foxyblocks/firewalker/docs/power-budget.md

# Power budget

Why current is the ceiling on this rig, and what the brightness settings mean for each
supported power setup.

## The numbers

BTF's [specification for the 160-pixel FCOB strip](https://www.btf-lighting.com/products/fcob-rgb-addressable-led-strip-dc5v-160pixels)
lists up to **8 W per meter at 5 V**. With 160 pixels per meter, that's about 10 mA per
pixel at full white. These are rated figures, not measurements of this strip, and its idle
current hasn't been measured yet either. Every connected pixel controller draws idle power
even when showing black.

A boot needs about **69 cm of strip, which is about 110 pixels**. That's a measured length
with the exact cut point still open, so these numbers will shift slightly. At full white:

| Strip | Pixels | Power | Current |
|---|---|---|---|
| One boot, cut to about 69 cm | ~110 | ~5.5 W | ~1.1 A |
| Both boots, if they ever share one supply | ~220 | ~11 W | ~2.2 A |
| Uncut bench strip | 160 | ~8 W | ~1.6 A |

The firmware applies brightness to every channel, so requested current scales roughly with
`brightness / 255`, and with how many channels and pixels are lit. For one boot:

| Brightness | ~110 pixels, white | ~110 pixels, 2-channel color | ~110 pixels, 1-channel color | Uncut strip, white |
|---|---|---|---|---|
| `16` | ~69 mA | ~46 mA | ~23 mA | ~100 mA |
| `32` | ~138 mA | ~92 mA | ~46 mA | ~200 mA |
| `64` | ~276 mA | ~184 mA | ~92 mA | ~400 mA |
| `96` (soft cap and default, 100% in the app) | ~414 mA | ~276 mA | ~138 mA | ~602 mA |
| `128` | ~552 mA | ~368 mA | ~184 mA | ~803 mA |
| `255` | ~1.1 A | ~733 mA | ~367 mA | ~1.6 A |

## What the patterns draw

- **rainbow-pool** cycles one hue through the spectrum, so a full strip passes through
  2-channel colors (yellow, cyan, magenta). It rests at 80% per-pixel brightness when
  level, and a level stomp flashes the whole strip **white**, which is its worst case.
- **fire-stomp** lights moving bands with white heads cooling through yellow and orange
  to red. Its white heads can use all three channels; overlapping bands can fill the strip.

## Power profiles

**USB, with the soft cap on.** The strip runs from the XIAO's 5V pad, which carries USB
power. Seeed's MG24 Sense schematic (v1.1) disagrees with itself about the path. Its wiring
sheet feeds the pad through one diode, D1 (PSBD2FD40V1H, printed "40V 1A 550mV@1A"), which
the board's own 3.3 V regulator shares. Its block diagram, and the pin map on Seeed's wiki,
put the pad straight on VBUS. Neither shows a fuse. If D1 is in the path, it limits the pad
to 1 A, and the strip gets up to about half a volt less than the USB supply. The USB source
sets its own limit too: 500 mA from a USB 2.0 computer port, and more from a USB-C charger
or power bank. Neither Seeed's MG24 wiki nor the schematic gives a current rating for the pad.

`LED_BRIGHTNESS_SOFT_CAP` in [`config.h`](../include/config.h) holds brightness at 96 while a
boot's soft cap is on, which it is on a new boot. On the
longest boot strip, 107 pixels, that keeps a full-white frame near 400 mA by its rating,
which fits even a USB 2.0 port, with or without D1. The uncut bench strip would reach
about 600 mA at that cap, so run it at a lower brightness. Not yet checked: whether D1 is
really in the path, its heat derating, the pad's trace width, and a meter reading on a real
board.

**External 5 V, with the soft cap off.** Feed the strip directly from a 5 V supply, with
grounds tied together (see [`wiring.md`](wiring.md)). Rate it for at least 1.5 A per cut strip,
which leaves headroom over the ~1.1 A full-white draw, or 2 A for the uncut strip. Then turn the
cap off from the remote: the Cap toggle beside the brightness percent, or `cap off`
([`remote-protocol.md`](remote-protocol.md)). With it off, brightness goes up to 255, about
1.07 A at full white on 107 pixels. That's over a USB 2.0 port's 500 mA and possibly over D1's
1 A, so don't run uncapped from USB. Each boot saves whether its cap is on, so turn it back on
before going back to USB.

Changing the soft cap's level takes a build flag, `FIREWALKER_LED_BRIGHTNESS_SOFT_CAP`. A capped
boot whose saved brightness is over a lower cap loads at the cap and keeps its other settings.

`./cli --brightness` accepts up to 255 regardless of the cap, because it's a deliberate
bench override. Keep it within the profile you're actually powering.

The final battery design is outside this budget, and is tracked in
[`open-questions.md`](open-questions.md).

## Levers to stay safe

- Lower the brightness, which scales everything.
- Reduce the recipe trail's `length` or `maxFronts` in `patterns/`.
- Estimate before raising anything: pixels lit × per-pixel current, against the real
  budget of the power source.
