foxyblocks/firewalker/docs/adr/0001-use-platformio-arduino-framework.md

# ADR-0001: Use PlatformIO with the Arduino framework

- **Status:** Accepted
- **Date:** 2026-05-31
- **Note:** The decision stands, but the boards and environments below are history. The
  current target is the XIAO MG24 Sense; see ADR-0004 and `platformio.ini`.

## Context

This is a wearable NeoPixel shoe project. We want a modern, reproducible,
VS Code-based workflow with real dependency management and CLI builds — not a
one-off Arduino IDE sketch. The first test board is an Arduino Uno R3
(ATmega328P / AVR). The project later moved to an Adafruit Feather RP2040 as
the active controller.

## Decision

Use **PlatformIO** as the build/dependency/upload tool, targeting the
**Arduino framework**. Configuration lives in `platformio.ini`, currently with
Adafruit Feather RP2040 environments for each runtime mode (`final_app`,
`fsr_debug`, `imu_debug`). Shared libraries (e.g. Adafruit NeoPixel) are declared
in the base `[env]`; mode-specific ones (e.g. Adafruit MPU6050 for `imu_debug`)
are added per-env so they aren't linked into builds that don't need them. All are
version-pinned via `lib_deps`.

## Consequences

- Reproducible CLI builds (`pio run`), uploads (`pio run -t upload`), and serial
  monitoring (`pio device monitor`) — scriptable and CI-friendly.
- Declarative, pinned dependencies instead of the IDE's global library mess.
- Switching/adding boards is a new `[env:*]` block; the Arduino framework keeps
  most application code portable across supported targets.
- Slightly more upfront config than the Arduino IDE, and contributors must
  install PlatformIO. Acceptable for a deliberate, long-lived project.

## Alternatives considered

- **Arduino IDE sketch** — lowest friction, but no real dependency pinning, no
  CLI/CI story, awkward multi-board support. Rejected.
- **Bare avr-gcc / Makefile** — maximal control, but we'd reinvent board
  definitions, upload, and the Arduino HAL the NeoPixel library expects.
  Rejected as premature.
