foxyblocks/firewalker/test/fixtures/recipe-frames/README.md

# Recipe reference frames

What the designer's TypeScript engine draws for a fixed script of motion and audio. A test of the firmware's
C++ engine can run the same inputs and compare pixels, with no boot needed.

The frames come only from the test recipes in `recipes/`. Recipes in `patterns/` aren't involved,
so saving or editing a pattern never changes anything here.

Regenerate them only after changing what the engine draws, or one of the test recipes:

```bash
cd designer
bun run reference-frames
```

`bun run test` fails if the frames don't match the engine, or if a layer type, blend, choice, or
knob source has no test recipe.

## What's here

| File | Holds |
|---|---|
| `recipes/*.json` | Small test recipes that exercise every layer type, blend, choice, and knob source. Edited by hand |
| `compiled/*.bin` | Generated. Each test recipe compiled, as a boot would receive it. A change here means the binary format changed |
| `manifest.json` | Generated. Every case: its frames file, recipe, and strip layout |
| `inputs.bin` | Generated. The motion and audio script, shared by every case |
| `<recipe>--<layout>.bin` | Generated. One recipe's expected frames on one strip layout |

Each frames file comes from the compiled recipe, decoded and run, not the JSON directly. Every test
recipe runs on two layouts: `bench` (160 pixels, toe 52, heel 132) and `heel-first` (107 pixels, toe 72,
heel 19). The first runs toe first with even arcs, and the second runs heel first with uneven ones, so they
catch different bugs. They're fixed here on purpose, so re-cutting a boot never changes these files.

## File formats

Numbers are little-endian.

**`inputs.bin`** is an 8-byte header, then one 12-byte record per frame.

| Offset | Type | Field |
|---|---|---|
| 0 | 4 bytes | `FWRI` |
| 4 | `uint16` | Input format, 2 |
| 6 | `uint16` | Frame count |

| Record offset | Type | Field |
|---|---|---|
| 0 | `float32` | Tilt, -1 to 1. Exactly 0 in the dead zone |
| 4 | `float32` | Stomp strength, 0 to 1 |
| 8 | `uint16` | Time since the previous frame, in ms |
| 10 | `uint8` | 1 if a stomp fired on this frame |
| 11 | `uint8` | Audio level, 0 to 255. Replay as `float32(byte / 255)` |

Input format 1 uses the same record size and treats byte 11 as silence. The native test reads
both formats. The audio script rises from silence to full, holds, then falls to silence.
The Band fixture combines it with tilt and stomp brightness on both strip layouts.

**`<recipe>--<layout>.bin`** is a 16-byte header, then the saved frames.

| Offset | Type | Field |
|---|---|---|
| 0 | 4 bytes | `FWRF` |
| 4 | `uint16` | File format, 1 |
| 6 | `uint16` | Pixel count |
| 8 | `uint16` | Toe pixel |
| 10 | `uint16` | Heel pixel |
| 12 | `uint16` | N: a frame is saved after every N updates |
| 14 | `uint16` | Saved frame count |

Each saved frame is R, G, B bytes for each pixel in strip order, as `floor(value × 255 + 0.5)`,
before the boot's brightness setting. The first saved frame comes after N updates. The engine still
runs every frame in between, so a difference in how state builds up shows at the next saved frame.

## Using them

Decode the case's compiled recipe, and start the engine fresh on its layout, as a boot does when it
switches to a pattern. Then feed it every record in `inputs.bin` in order, and compare at each saved
frame.

C++ does its math differently from JavaScript in small ways, so allow a difference of 1 per channel.
