foxyblocks/firewalker/src/modes/final_app.cpp

// final_app is the shoe app, and the same binary runs on both shoes. The onboard
// sensor drives the active pattern, the remote (BLE or the USB console) changes
// settings, and each controller keeps its own pattern, brightness, soft cap, calibrated
// poses, and strip layout in flash. Losing the phone never matters: whatever is
// running keeps running, and a reconnecting client is told the current state.
//
// Each loop pass reads the sensor, handles any remote commands, saves settings that
// are due, and renders at most one frame. See docs/remote-protocol.md for commands.
// firewalker_pattern_list.h resolves names and restores saved selections; RecipePattern
// renders the chosen built-in or uploaded bytes through the shared recipe engine.

#include "modes/final_app.h"

#include <Arduino.h>

#include "config.h"
#include "firewalker_core.h"
#include "firewalker_audio.h"
#include "firewalker_calibration.h"
#include "firewalker_imu.h"
#include "firewalker_pattern_list.h"
#include "firewalker_recipe_store.h"
#include "firewalker_recipe_upload.h"
#include "firewalker_remote.h"
#include "firewalker_remote_protocol.h"
#include "firewalker_settings.h"
#include "firewalker_settings_store.h"
#include "generated/recipe_builtins.h"
#include "patterns/pattern.h"
#include "patterns/recipe_pattern.h"

namespace FinalAppMode {

using namespace Firewalker;

static constexpr SettingsBounds SETTINGS_BOUNDS = {LED_BRIGHTNESS_MIN, LED_BRIGHTNESS_MAX,
                                                   STRIP_MAX_PIXELS,
                                                   LED_BRIGHTNESS_SOFT_CAP};
// Every file in src/modes/ compiles into every build, and bench builds set their own brightness
// with a build flag (up to 255, from ./cli --brightness), so this check is for the app build only.
#if defined(FIREWALKER_MODE_FINAL_APP)
static_assert(LED_BRIGHTNESS <= LED_BRIGHTNESS_SOFT_CAP,
              "A new boot starts with the soft cap on, so its default brightness must fit under it");
#endif
static constexpr PoseCaptureLimits CAPTURE_LIMITS = {
    CALIBRATION_WINDOW_MS, CALIBRATION_NO_SAMPLE_MS, CALIBRATION_MIN_SAMPLES,
    CALIBRATION_MAX_SPREAD_DEG};

static RecipePattern recipePattern;
static Pattern* activePattern = nullptr;  // null when the strip is off

static UploadedRecipe uploads[RECIPE_SLOTS];
static const PatternCatalog CATALOG = {RECIPE_BUILTINS, RECIPE_BUILTIN_COUNT, uploads, RECIPE_SLOTS};
static RecipeUpload upload(RECIPE_UPLOAD_IDLE_MS);
// Static, because it's too big for the loop's stack.
static uint8_t storedRecipeBytes[RECIPE_MAX_BYTES];

static Settings settings = defaultSettings(LED_BRIGHTNESS, STRIP_DEFAULT_LAYOUT);
static SaveScheduler saveScheduler(SETTINGS_SAVE_QUIET_MS, SETTINGS_SAVE_MAX_MS);
static bool saveFailed = false;

static OrientationCalibrator calibrator(CAPTURE_LIMITS, ORIENTATION_LIMITS);

static bool identifying = false;
static unsigned long identifyStartMs = 0;

static bool stripPreview = false;
static unsigned long lastStripCommandMs = 0;  // a preview ends STRIP_PREVIEW_HOLD_MS after this

static bool debugEnabled = false;
static bool statusPending = false;
static bool stompPending = false;         // fired since the last frame
static bool stompSinceReport = false;     // fired since the last motion line
static float accelPeak = 0.0f;            // highest acceleration since the last motion line
static bool patternStarting = false;     // the next pattern frame starts at elapsed time zero
static unsigned long lastFrameMs = 0;
static unsigned long lastStatusMs = 0;
static unsigned long lastMotionMs = 0;
static uint32_t slowestFrameUs = 0;       // slowest pattern update since the last motion line

static void sendStatus() {
  StatusReport report{};
  report.id = remoteDeviceId();
  report.pattern = settings.pattern;
  report.lit = settings.lastLitPattern;
  report.brightness = settings.brightness;
  report.maxBrightness = brightnessCeiling(settings, SETTINGS_BOUNDS);
  report.capped = settings.capped;
  report.capBrightness = LED_BRIGHTNESS_SOFT_CAP;
  report.sensorReady = imuReady();
  report.tilt = imuTiltFwd();
  report.calibration = orientationReport(settings.orientation);
  report.orientationCalibrated = orientationCalibrated(settings.orientation);
  report.calibrationState = calibrator.statusText();
  report.saved = !saveScheduler.dirty() && !saveFailed;
  report.saveFailed = saveFailed;
  report.saves = settingsWriteCount();
  report.debug = debugEnabled;
  report.bleConnected = remoteBleConnected();
  report.strip = settings.strip;
  report.maxLeds = STRIP_MAX_PIXELS;
  report.preview = stripPreview;

  char line[REMOTE_LINE_MAX];
  formatStatus(line, sizeof(line), report);
  remoteSend(line);
  lastStatusMs = millis();
  statusPending = false;
}

static void sendAck(CommandType type, bool ok, const char* error = nullptr) {
  char line[REMOTE_LINE_MAX];
  formatAck(line, sizeof(line), type, ok, error);
  remoteSend(line);
}

static void sendAudioConfig() {
  char line[REMOTE_LINE_MAX];
  snprintf(line, sizeof(line),
      "{\"t\":\"audio-config\",\"ready\":%s,\"noiseFloor\":%u,\"sensitivity\":%u,\"calibrating\":%s,\"saved\":%s}",
      audioReady() ? "true" : "false", (unsigned)settings.audioNoiseFloor,
      (unsigned)settings.audioSensitivity, audioCalibrating() ? "true" : "false",
      !saveScheduler.dirty() && !saveFailed ? "true" : "false");
  remoteSend(line);
}

static void saveNow() {
  saveFailed = !saveSettings(settings);
  saveScheduler.markSaved();
  statusPending = true;
}

static void sendPatterns() {
  const char* names[PATTERN_LIST_MAX];
  const uint8_t count = listPatterns(CATALOG, names, PATTERN_LIST_MAX);
  char line[REMOTE_LINE_MAX];
  formatPatterns(line, sizeof(line), names, count);
  remoteSend(line);
}

// Puts what a name refers to on the strip. Returns false if the name doesn't mean anything on this
// boot or its recipe won't load, and the strip then stays as it was. Motion processing carries on
// either way, so turning the strip back on picks up the current tilt straight away.
static bool tryShowPattern(const char* name) {
  const PatternLookup found = findPattern(CATALOG, name);
  Pattern* next = nullptr;
  switch (found.source) {
    case PatternSource::Unknown:
      return false;
    case PatternSource::Off:
      break;
    case PatternSource::BuiltIn: {
      const BuiltInRecipe& recipe = RECIPE_BUILTINS[found.index];
      if (recipePattern.load(recipe.bytes, recipe.size) != RecipeDecodeResult::Ok) return false;
      next = &recipePattern;
      break;
    }
    case PatternSource::Uploaded: {
      const UploadedRecipe& recipe = uploads[found.index];
      if (!recipeStoreRead(found.index, storedRecipeBytes, recipe.size)) return false;
      if (recipePattern.load(storedRecipeBytes, recipe.size) != RecipeDecodeResult::Ok) return false;
      next = &recipePattern;
      break;
    }
  }

  activePattern = next;
  if (activePattern) {
    activePattern->enter();
  } else {
    strip.clear();
    strip.show();
  }
  patternStarting = activePattern != nullptr;
  stompPending = false;
  return true;
}

// Restores both saved selections against the current catalog before showing the active one.
// This also updates the remembered pattern while off. An unreadable recipe falls back to
// rainbow-pool without disturbing brightness, poses, or strip layout.
static void showSavedPattern() {
  if (restoreSavedPatterns(CATALOG, settings)) saveScheduler.markChanged(millis());
  if (tryShowPattern(settings.pattern)) return;
  Serial.print(F("[firewalker] can't show saved pattern: "));
  Serial.println(settings.pattern);
  copyPatternName(settings.pattern, PATTERN_DEFAULT);
  saveScheduler.markChanged(millis());
  tryShowPattern(settings.pattern);
}

// Restart on every explicit pattern selection so both boots can start from the same point.
// Power commands only switch patterns when the requested power state changes. Returns false
// if the pattern can't be shown, which leaves the settings and the strip alone.
static bool selectPattern(const char* name, bool restartIfActive) {
  if (restartIfActive || strcmp(name, settings.pattern) != 0) {
    if (!tryShowPattern(name)) return false;
    copyPatternName(settings.pattern, name);
  } else if (findPattern(CATALOG, name).source == PatternSource::Unknown) {
    return false;
  }
  if (strcmp(name, PATTERN_OFF) != 0) copyPatternName(settings.lastLitPattern, name);
  saveScheduler.markChanged(millis());
  return true;
}

static void sendRecipeAck(bool ok, const char* error = nullptr, int32_t next = -1) {
  char line[REMOTE_LINE_MAX];
  formatRecipeAck(line, sizeof(line), ok, error, next);
  remoteSend(line);
}

// Checks the finished upload and saves it. This is the only point an upload touches flash, and it's
// one write, so a power cut leaves the old recipe or the new one. A recipe that's on the strip restarts
// as the new version, which makes tuning one on a boot quick.
static void finishUpload() {
  const char* failure = upload.finish(recipePattern.scratch());
  if (failure) {
    sendRecipeAck(false, failure);
    return;
  }

  const int16_t slot = uploadSlotFor(uploads, RECIPE_SLOTS, upload.name());
  if (slot < 0) {
    sendRecipeAck(false, "no-room");
    return;
  }
  if (!recipeStoreWrite((uint8_t)slot, upload.bytes(), upload.size())) {
    sendRecipeAck(false, "save-failed");
    return;
  }
  describeStoredRecipe(upload.bytes(), upload.size(), uploads[slot]);
  sendRecipeAck(true);
  sendPatterns();
  if (strcmp(settings.pattern, upload.name()) == 0) showSavedPattern();
  statusPending = true;
}

// Deletes an upload. If it was on the strip or what turning on returns to, a built-in of the same name
// takes over if there is one, and otherwise the boot falls back to rainbow-pool.
static void deleteUpload(const char* name) {
  int16_t slot = -1;
  for (uint8_t i = 0; i < RECIPE_SLOTS; i++) {
    if (uploads[i].used && strcmp(uploads[i].name, name) == 0) slot = i;
  }
  if (slot < 0) {
    const bool builtIn = findPattern(CATALOG, name).source == PatternSource::BuiltIn;
    sendRecipeAck(false, builtIn ? "built-in" : "not-found");
    return;
  }
  if (!recipeStoreDelete((uint8_t)slot)) {
    sendRecipeAck(false, "save-failed");
    return;
  }
  uploads[slot] = UploadedRecipe{};
  sendRecipeAck(true);
  sendPatterns();
  if (strcmp(settings.pattern, name) == 0 || strcmp(settings.lastLitPattern, name) == 0) showSavedPattern();
  statusPending = true;
}

// Handles every `recipe` command and `recipes`. They reply for themselves, and only send a status line
// when something has actually changed.
static void handleRecipeCommand(const Command& command) {
  char line[REMOTE_LINE_MAX];
  switch (command.type) {
    case CommandType::Recipes:
      formatRecipes(line, sizeof(line), RECIPE_VERSION, uploads, RECIPE_SLOTS);
      remoteSend(line);
      return;

    case CommandType::RecipeInfo: {
      for (const UploadedRecipe& recipe : uploads) {
        if (recipe.used && strcmp(recipe.name, command.pattern) == 0) {
          formatRecipeInfo(line, sizeof(line), recipe);
          remoteSend(line);
          return;
        }
      }
      sendRecipeAck(false, "not-found");
      return;
    }

    case CommandType::RecipeBegin: {
      const char* failure = upload.begin(command.pattern, command.value, millis());
      if (!failure && uploadSlotFor(uploads, RECIPE_SLOTS, command.pattern) < 0) {
        upload.cancel();
        failure = "no-room";
      }
      sendRecipeAck(failure == nullptr, failure, failure ? -1 : 0);
      return;
    }

    case CommandType::RecipeData: {
      const char* failure = upload.data(command.value, command.hex, millis());
      sendRecipeAck(failure == nullptr, failure, upload.active() ? (int32_t)upload.next() : -1);
      return;
    }

    case CommandType::RecipeEnd:
      finishUpload();
      return;

    case CommandType::RecipeCancel:
      upload.cancel();
      sendRecipeAck(true);
      return;

    case CommandType::RecipeDelete:
      deleteUpload(command.pattern);
      return;

    default:
      return;
  }
}

// Shows or stops showing a strip layout preview, which takes over the strip from the
// pattern without changing any settings. Each call keeps a preview alive for another
// STRIP_PREVIEW_HOLD_MS. Stopping brings back the saved brightness and restarts the pattern.
static void setStripPreview(bool on) {
  lastStripCommandMs = millis();
  if (on == stripPreview) return;
  stripPreview = on;
  if (!on) {
    strip.setBrightness(settings.brightness);
    showSavedPattern();
  }
}

static void handleCommand(const Command& command) {
  switch (command.type) {
    case CommandType::Invalid:
      sendAck(CommandType::Invalid, false, command.error);
      return;

    case CommandType::Audio:
      sendAudioConfig();
      return;

    case CommandType::AudioSensitivity:
      if (audioCalibrating()) {
        sendAck(command.type, false, "calibration-in-progress");
        return;
      }
      settings.audioSensitivity = (uint8_t)command.value;
      audioConfigure(settings.audioNoiseFloor, settings.audioSensitivity);
      saveScheduler.markChanged(millis());
      sendAck(command.type, true);
      sendAudioConfig();
      return;

    case CommandType::AudioCalibrate:
      // A repeated line after a lost reply adopts the existing capture.
      if (audioCalibrating()) {
        sendAck(command.type, true);
        sendAudioConfig();
        return;
      }
      if (!audioStartQuietCalibration()) {
        sendAck(command.type, false, audioReady() ? "calibration-in-progress" : "audio-unavailable");
        return;
      }
      sendAck(command.type, true);
      sendAudioConfig();
      return;

    case CommandType::Status:
      sendStatus();
      return;

    case CommandType::Patterns:
      sendPatterns();
      return;

    case CommandType::Recipes:
    case CommandType::RecipeInfo:
    case CommandType::RecipeBegin:
    case CommandType::RecipeData:
    case CommandType::RecipeEnd:
    case CommandType::RecipeCancel:
    case CommandType::RecipeDelete:
      handleRecipeCommand(command);
      return;

    // Blinks the strip and onboard user LED together. It changes no settings, so
    // there's nothing new to report and nothing to save.
    case CommandType::Identify:
      identifying = true;
      identifyStartMs = millis();
      sendAck(command.type, true);
      return;

    case CommandType::Pattern:
      if (findPattern(CATALOG, command.pattern).source == PatternSource::Unknown) {
        sendAck(command.type, false, "unknown-pattern");
        return;
      }
      if (!selectPattern(command.pattern, /*restartIfActive=*/true)) {
        sendAck(command.type, false, "bad-recipe");
        return;
      }
      sendAck(command.type, true);
      break;

    case CommandType::Power: {
      char target[PATTERN_NAME_SIZE];
      copyPatternName(target, command.on ? settings.lastLitPattern : PATTERN_OFF);
      if (!selectPattern(target, /*restartIfActive=*/false)) showSavedPattern();
      sendAck(command.type, true);
      break;
    }

    case CommandType::Brightness:
      if (command.value < LED_BRIGHTNESS_MIN ||
          command.value > brightnessCeiling(settings, SETTINGS_BOUNDS)) {
        sendAck(command.type, false, "out-of-range");
        return;
      }
      settings.brightness = (uint8_t)command.value;
      strip.setBrightness(settings.brightness);
      saveScheduler.markChanged(millis());
      sendAck(command.type, true);
      break;

    // Turning the cap on can lower the brightness, so the strip takes the new level right away,
    // unless a layout preview has it at its own fixed brightness for now. Either way the change
    // is saved, so the boot powers up the same way.
    case CommandType::Cap:
      if (setBrightnessCap(settings, command.on, SETTINGS_BOUNDS)) {
        if (!stripPreview) strip.setBrightness(settings.brightness);
        saveScheduler.markChanged(millis());
      }
      sendAck(command.type, true);
      break;

    case CommandType::Calibrate: {
      const char* refusal = calibrator.start(command.pose, millis(), imuReady());
      sendAck(command.type, refusal == nullptr, refusal);
      break;
    }

    case CommandType::CalibrationClear: {
      const char* refusal = calibrator.clear(command.clearTarget, settings.orientation);
      if (refusal) {
        sendAck(command.type, false, refusal);
        return;
      }
      // Clearing is a saved calibration change, just like a completed capture.
      // Patterns use it immediately; status reports any flash-write failure.
      imuSetCalibration(settings.orientation);
      saveNow();
      sendAck(command.type, true);
      break;
    }

    case CommandType::Debug:
      debugEnabled = command.on;
      sendAck(command.type, true);
      break;

    // Saves after the changes pause, so dragging a slider becomes one flash write. Patterns
    // read the layout when they enter, so one showing now restarts to pick it up. A preview
    // draws straight from the settings, and the pattern restarts when the preview ends.
    case CommandType::StripSet: {
      const char* failure =
          applyStripSetting(settings.strip, command.stripField, command.value, STRIP_MAX_PIXELS);
      if (failure) {
        sendAck(command.type, false, failure);
        return;
      }
      setStripLayout(settings.strip);
      saveScheduler.markChanged(millis());
      lastStripCommandMs = millis();
      if (!stripPreview) showSavedPattern();
      sendAck(command.type, true);
      break;
    }

    case CommandType::StripPreview:
      setStripPreview(command.on);
      sendAck(command.type, true);
      break;
  }
  statusPending = true;
}

// Tells clients about each change in a capture. An applied pose is saved right away, because a
// calibration is worth more than the wear of one write. A failure has changed nothing, in use
// or in flash.
static void updatePoseCapture() {
  const CaptureReport report = calibrator.update(millis(), settings.orientation);
  if (report.kind == CaptureReportKind::None) return;

  char line[REMOTE_LINE_MAX];
  if (report.kind == CaptureReportKind::Started) {
    formatCalibrationCapturing(line, sizeof(line), report.pose);
  } else if (report.kind == CaptureReportKind::Failed) {
    formatCalibrationFailed(line, sizeof(line), report.pose, report.reason);
  } else {
    imuSetCalibration(settings.orientation);
    saveNow();
    formatCalibrationOk(line, sizeof(line), report.pose, report.angleDeg, imuTiltFwd());
  }
  remoteSend(line);
  statusPending = true;
}

// Lines stay under the motion rate limit, and they drop first if BLE falls behind.
static void sendMotionIfDue(unsigned long now) {
  if (!debugEnabled || (now - lastMotionMs) < REMOTE_MOTION_REPORT_MS) return;
  lastMotionMs = now;

  char line[REMOTE_LINE_MAX];
  formatMotion(line, sizeof(line), imuTiltFwd(), imuTiltDeg(), imuLatest().mag, accelPeak,
               imuGyroMagnitude(), stompSinceReport, imuStompStrength(), slowestFrameUs);
  remoteSend(line, RemotePriority::Telemetry);
  const AudioSample& audio = audioLatest();
  char waveform[AUDIO_WAVEFORM_SIZE * 7 + 3];
  size_t used = 0;
  waveform[used++] = '[';
  for (size_t i = 0; i < AUDIO_WAVEFORM_SIZE; i++) {
    char sample[16];
    formatFixed2(sample, sizeof(sample), audioReady() ? (float)audio.waveform[i] / 127.0f : 0);
    used += snprintf(waveform + used, sizeof(waveform) - used, "%s%s", i ? "," : "", sample);
  }
  snprintf(waveform + used, sizeof(waveform) - used, "]");
  char levelText[16], rmsText[16], meanText[16];
  formatFixed2(levelText, sizeof(levelText), audio.level);
  formatFixed2(rmsText, sizeof(rmsText), audio.block.rms);
  formatFixed2(meanText, sizeof(meanText), audio.block.mean);
  snprintf(line, sizeof(line),
      "{\"t\":\"audio\",\"ready\":%s,\"level\":%s,\"rms\":%s,\"mean\":%s,\"low\":%u,\"high\":%u,\"blocks\":%lu,\"captureUs\":%lu,\"waveform\":%s}",
      audioReady() ? "true" : "false", levelText, rmsText, meanText,
      (unsigned)audio.block.low, (unsigned)audio.block.high,
      (unsigned long)audio.blocks, (unsigned long)audio.captureUs, waveform);
  remoteSend(line, RemotePriority::Telemetry);
  stompSinceReport = false;
  accelPeak = 0.0f;
  slowestFrameUs = 0;
}

// Draws the whole strip layout at once: the ring in blue, with the toe and heel pixels in
// their own colors on top. Past the end of the ring stays dark, so on an uncut strip you can
// see where the ring ends, and you can see all three settings while changing any of them.
static void drawStripPreview() {
  strip.setBrightness(STRIP_PREVIEW_BRIGHTNESS);
  strip.clear();
  for (uint16_t i = 0; i < strip.numPixels(); i++) strip.setPixelColor(i, STRIP_PREVIEW_LEDS_COLOR);
  strip.setPixelColor(settings.strip.toe, STRIP_PREVIEW_TOE_COLOR);
  strip.setPixelColor(settings.strip.heel, STRIP_PREVIEW_HEEL_COLOR);
  strip.show();
}

// Draws one frame, at most every APP_FRAME_MS so the strip can't take all of the
// loop's time from the sensor and the radio. With the strip off, a black frame now
// and then keeps it dark if the strip's power was cycled separately.
static void renderIfDue(unsigned long now) {
  // Identify owns both lights briefly, then the saved pattern and normal status return.
  if (identifying) {
    stompPending = false;
    const unsigned long elapsed = now - identifyStartMs;
    if (elapsed >= IDENTIFY_MS) {
      identifying = false;
      showSavedPattern();
    } else if ((now - lastFrameMs) >= APP_FRAME_MS) {
      lastFrameMs = now;
      // Start dark so Blink immediately changes the normally solid onboard light.
      // One phase drives both outputs, including when the saved strip pattern is Off.
      renderIdentifyBlink((elapsed / IDENTIFY_BLINK_MS) % 2 != 0);
    }
    return;
  }

  if (stripPreview) {
    stompPending = false;
    if ((now - lastFrameMs) >= APP_FRAME_MS) {
      lastFrameMs = now;
      drawStripPreview();
    }
    return;
  }

  if (!activePattern) {
    if ((now - lastFrameMs) >= APP_OFF_REFRESH_MS) {
      lastFrameMs = now;
      strip.clear();
      strip.show();
    }
    stompPending = false;
    return;
  }
  const unsigned long elapsed = now - lastFrameMs;
  if (elapsed < APP_FRAME_MS) return;
  lastFrameMs = now;

  PatternInput input;
  input.tiltFwd = imuTiltFwd();
  input.stomp = stompPending;
  input.stompStrength = imuStompStrength();
  input.dt = patternStarting ? 0 : elapsed;
  input.audioLevel = audioLevel();
  patternStarting = false;
  stompPending = false;
  const uint32_t updateStart = micros();
  activePattern->update(input);
  const uint32_t updateUs = micros() - updateStart;
  if (updateUs > slowestFrameUs) slowestFrameUs = updateUs;
}

void setup() {
  setupCore(F("final_app"));

  const char* loaded = loadSettings(SETTINGS_BOUNDS, settings);
  Serial.print(F("[firewalker] settings: "));
  Serial.println(loaded);

  audioConfigure(settings.audioNoiseFloor, settings.audioSensitivity);
  audioBegin();
  imuBegin();
  imuSetCalibration(settings.orientation);

  recipeStoreLoad(uploads, RECIPE_SLOTS);

  remoteBegin();
  setStripLayout(settings.strip);
  strip.setBrightness(settings.brightness);
  showSavedPattern();
  sendStatus();
}

void loop() {
  audioUpdate();
  uint8_t quietFloor;
  if (audioTakeQuietCalibration(quietFloor)) {
    settings.audioNoiseFloor = quietFloor;
    audioConfigure(settings.audioNoiseFloor, settings.audioSensitivity);
    saveScheduler.markChanged(millis());
    sendAudioConfig();
  }
  if (imuUpdate()) {
    if (imuTakeStomp()) {
      stompPending = true;
      stompSinceReport = true;
    }
    if (imuLatest().mag > accelPeak) accelPeak = imuLatest().mag;
    calibrator.addSample(millis(), imuGravity());
  }
  updatePoseCapture();

  char line[REMOTE_COMMAND_MAX + 1];
  while (remoteNextLine(line, sizeof(line))) {
    handleCommand(parseCommand(line));
  }

  // Read the clock after handling commands, which stamp their changes with millis().
  // An earlier reading could make a command's preview or identify timer appear to wrap around.
  const unsigned long now = millis();

  if (saveScheduler.due(now)) saveNow();

  if (upload.timedOut(now)) upload.cancel();

  if (stripPreview && (now - lastStripCommandMs) >= STRIP_PREVIEW_HOLD_MS) {
    setStripPreview(false);
    statusPending = true;
  }

  if (remoteTakeClientReady()) statusPending = true;
  if (statusPending && (now - lastStatusMs) >= REMOTE_STATUS_MIN_MS) sendStatus();
  sendMotionIfDue(now);

  renderIfDue(now);

  // Identify renders the onboard LED with the strip. Do not overwrite it with a
  // status blink on the same pass; normal status resumes as soon as identify ends.
  if (!identifying) {
    updateStatusLight(calibrator.capturing() ? StatusLight::Calibrating
                      : imuReady()          ? StatusLight::Running
                                            : StatusLight::SensorMissing);
  }
  remoteUpdate();
}

}  // namespace FinalAppMode
