foxyblocks/firewalker/include/config.h

#pragma once

// Central knobs for the Firewalker firmware: every pin, strip, brightness, motion,
// and pattern setting lives here, named by the module that owns it. Build flags
// may override the strip size, layout, and brightness for test builds.

#include <Arduino.h>
#include "em_iadc.h"
#include <stddef.h>

#include "firewalker_calibration.h"
#include "firewalker_orientation.h"
#include "firewalker_strip_map.h"

// ── Serial ──────────────────────────────────────────────────────────────
// Must match `monitor_speed` in platformio.ini.
constexpr unsigned long SERIAL_BAUD = 115200;

// The Sense board's analog microphone. IADC0's internal timer and a DMA block
// keep capture independent of the app's frame rate and of SPI's LED transfers.
constexpr PinName AUDIO_POWER_PIN = PC8;
constexpr GPIO_Port_TypeDef AUDIO_DATA_PORT = gpioPortC;
constexpr unsigned int AUDIO_DATA_PIN = 9;
constexpr IADC_PosInput_t AUDIO_ADC_INPUT = iadcPosInputPortCPin9;
constexpr uint32_t AUDIO_SAMPLE_HZ = 8000;
constexpr uint32_t AUDIO_ADC_SOURCE_HZ = 20000000;
constexpr uint32_t AUDIO_ADC_CLOCK_HZ = 10000000;
constexpr uint32_t AUDIO_REFERENCE_MV = 3300;
constexpr size_t AUDIO_BLOCK_SAMPLES = 128;
constexpr unsigned long AUDIO_STARTUP_MS = 20;
constexpr unsigned long AUDIO_STALE_MS = 250;
constexpr unsigned long AUDIO_CALIBRATION_MS = 1200;
constexpr size_t AUDIO_CALIBRATION_SAMPLES = 80;
constexpr float AUDIO_GATE_OPEN_MULTIPLIER = 1.5f;
constexpr uint8_t AUDIO_GATE_OPEN_BLOCKS = 2;
constexpr float AUDIO_ATTACK_MS = 20.0f;
constexpr float AUDIO_RELEASE_MS = 180.0f;

// ── Strip ───────────────────────────────────────────────────────────────
// BTF FCOB-5V-160L-W-IP30-SPI-5MM: a nominal 1m of 160 individually addressable
// pixels, XGB1338 (WS2812B-compatible, GRB, 800 kHz). Data is on D10, which is SPI
// MOSI. The signal comes from the SPI hardware, so it can't move to another pin freely.

// The uncut bench strip, and where its ring layout starts. FIREWALKER_LED_COUNT sizes the
// frame buffers, so it's the most pixels this build can drive. Each controller then saves
// the count, toe, and heel that fit its own boot, set from the remote while looking at the
// strip (docs/remote-protocol.md), so a cut strip needs no firmware change. The toe and heel
// here scale the original 40-pixel ring by four, and only apply until a boot saves its own.
// The cli tool reads these too. Test builds override them with build flags, and every source
// file sees the same values.
#ifndef FIREWALKER_LED_COUNT
#define FIREWALKER_LED_COUNT 160
#endif
#ifndef FIREWALKER_STRIP_TOE_INDEX
#define FIREWALKER_STRIP_TOE_INDEX 52
#endif
#ifndef FIREWALKER_STRIP_HEEL_INDEX
#define FIREWALKER_STRIP_HEEL_INDEX 132
#endif
constexpr uint16_t STRIP_MAX_PIXELS = FIREWALKER_LED_COUNT;

// The strip is a closed loop around the foot perimeter: pixel 0 starts directly
// under the controller, then the indices run around the foot and return to the
// start. The pure index-to-fore-aft math and the rules for a valid layout live in
// include/firewalker_strip_map.h (tested in test/test_strip_map).
constexpr Firewalker::StripLayout STRIP_DEFAULT_LAYOUT = {
    STRIP_MAX_PIXELS, FIREWALKER_STRIP_TOE_INDEX, FIREWALKER_STRIP_HEEL_INDEX};
static_assert(Firewalker::stripLayoutValid(STRIP_DEFAULT_LAYOUT, STRIP_MAX_PIXELS),
              "Strip layout needs at least 2 pixels, with toe and heel on different pixels");

// Signal timing. src/firewalker_strip.cpp turns each LED bit into four bits of SPI at
// this rate, which sets every pulse width. 3.25 MHz divides evenly from the board's
// 39 MHz clock. Re-check black frames, fixed colors, and animations on the real strip
// after any change, because a successful upload doesn't verify the signal.
constexpr uint32_t STRIP_SPI_HZ   = 3250000;
constexpr uint32_t STRIP_LATCH_US = 300;

// The soft cap: the highest brightness a boot accepts while its cap is on. A new boot starts
// with it on, and it stays on until someone turns it off from the remote (`cap off` in
// docs/remote-protocol.md). Each boot saves whether its cap is on. A boot's strip is cut to at
// most 107 pixels, rated about 10 mA each at full white, so 96/255 keeps a full-white frame
// near 400 mA. That fits a USB 2.0 port's 500 mA, and the 1 A diode Seeed's schematic may put
// in front of the XIAO's 5V pad. With the cap off, brightness goes up to LED_BRIGHTNESS_MAX,
// about 1.07 A at full white on 107 pixels, which needs a dedicated 5 V supply rather than USB.
// docs/power-budget.md has the numbers and that setup.
#ifndef FIREWALKER_LED_BRIGHTNESS_SOFT_CAP
#define FIREWALKER_LED_BRIGHTNESS_SOFT_CAP 96
#endif
constexpr uint8_t LED_BRIGHTNESS_SOFT_CAP = FIREWALKER_LED_BRIGHTNESS_SOFT_CAP;
// The most a channel can be scaled to, so the highest brightness with the soft cap off.
constexpr uint8_t LED_BRIGHTNESS_MAX = 255;
constexpr uint8_t LED_BRIGHTNESS_MIN = 1;
static_assert(LED_BRIGHTNESS_SOFT_CAP >= LED_BRIGHTNESS_MIN,
              "The soft cap must leave room for at least LED_BRIGHTNESS_MIN");

// Default brightness (0-255) on first boot: the soft cap, which the app shows as 100% while
// the cap is on. After that each controller restores its own saved value. Brightness scales
// requested color and is not a current limit. Build flags set it for test builds. The
// designer's simulator starts at this value too (designer/src/engine/output.ts).
#ifndef FIREWALKER_LED_BRIGHTNESS
#define FIREWALKER_LED_BRIGHTNESS FIREWALKER_LED_BRIGHTNESS_SOFT_CAP
#endif
constexpr uint8_t LED_BRIGHTNESS = FIREWALKER_LED_BRIGHTNESS;
static_assert(LED_BRIGHTNESS >= LED_BRIGHTNESS_MIN && LED_BRIGHTNESS <= 255,
              "Default brightness must be at least LED_BRIGHTNESS_MIN");

// What the strip shows while a remote sets its layout (`strip preview`): the ring in blue,
// with the toe and heel pixels in their own colors. These are the app's slider colors, and
// the fixed brightness means the markers are easy to find even on a boot turned down low. It's
// the soft cap, so a preview stays inside what USB can supply whether or not the cap is on. A
// preview ends by itself this long after the latest strip command, so a phone that goes
// away can't leave a boot stuck showing it.
constexpr uint32_t      STRIP_PREVIEW_LEDS_COLOR = 0x0000FF;  // blue
constexpr uint32_t      STRIP_PREVIEW_TOE_COLOR  = 0xFFC800;  // yellow
constexpr uint32_t      STRIP_PREVIEW_HEEL_COLOR = 0x8000FF;  // purple
constexpr uint8_t       STRIP_PREVIEW_BRIGHTNESS = LED_BRIGHTNESS_SOFT_CAP;
constexpr unsigned long STRIP_PREVIEW_HOLD_MS    = 60000;

// ── Onboard status LED ───────────────────────────────────────────────────
// Half-periods of the onboard LED's blink patterns (firewalker_core.h StatusLight).
constexpr unsigned long STATUS_BLINK_SLOW_MS = 500;
constexpr unsigned long STATUS_BLINK_FAST_MS = 100;

// ── IMU motion sensor (onboard LSM6DS3TR-C) ─────────────────────────────
// The MG24 Sense's onboard accel + gyro, on the default I2C bus. PD5 powers it and
// must go high before the sensor starts. src/firewalker_imu.cpp converts readings
// to m/s^2 *including* gravity and rad/s, so at rest the total magnitude sits near
// 9.81 and a stomp is a spike well above it.
constexpr uint8_t       IMU_I2C_ADDR = 0x6A;
constexpr uint8_t       IMU_ENABLE_PIN = PD5;
constexpr unsigned long IMU_SAMPLE_MS = 20;    // ~50 Hz accel/gyro poll
constexpr unsigned long IMU_LOG_MS = 100;      // throttle verbose serial to ~10 Hz
constexpr float         IMU_GRAVITY = 9.81f;   // rest |accel| baseline (m/s^2)

// Stomp detect on total acceleration magnitude with hysteresis + a refractory
// gap. Starting points to tune on a real foot (see open-questions.md).
constexpr float         IMU_STOMP_ACCEL_THRESHOLD   = 18.0f;  // fire above this |accel|
constexpr float         IMU_RELEASE_ACCEL_THRESHOLD = 12.0f;  // re-arm below this |accel|
constexpr unsigned long IMU_REFRACTORY_MS = 250;              // min gap between stomps

// Stomp "force" → trail brightness. imuStompStrength() normalizes the |accel| at
// the trigger sample from the threshold (0) up to IMU_STOMP_FORCE_FULL (1); a
// firm stomp spikes higher than a gentle step, so harder steps drive brighter
// trails. The trigger itself is unchanged — this only reads how hard it hit.
constexpr float         IMU_STOMP_FORCE_FULL = 40.0f;  // |accel| (m/s^2) → full-brightness trail

// ── Orientation fusion ───────────────────────────────────────────────────
// All three axes feed gravity tracking; held poses teach the boot mounting.
constexpr float   IMU_FILTER_ALPHA  = 0.96f;  // complementary-filter weight on the gyro term

// ── Tilt calibration ─────────────────────────────────────────────────────
// How learned 3D orientation becomes tilt (include/firewalker_orientation.h). A side with no
// captured heel or toe pose reaches full tilt at IMU_TILT_FULL_DEG from neutral. The dead
// zone is in degrees, so a calibrated boot rests exactly flat even if it settles a little
// off its captured neutral. Neutral can sit at any mounting angle in the fore-aft plane.
constexpr float   IMU_TILT_FULL_DEG     = 30.0f;
constexpr float   IMU_TILT_DEADZONE_DEG = 3.0f;
constexpr float IMU_ACCEL_GRAVITY_TOLERANCE = 2.0f;  // ignore impact acceleration for orientation correction
constexpr Firewalker::OrientationLimits ORIENTATION_LIMITS = {
    IMU_TILT_FULL_DEG,
    IMU_TILT_DEADZONE_DEG,
    10.0f,  // a heel or toe pose must sit at least this far from neutral
    30.0f,  // maximum disagreement between heel/toe rotation planes
};

// How a capture finds a pose in a hold, which is judged as a whole at the end of the window
// (OrientationCalibrator in include/firewalker_orientation.h). These are generous because the poses
// are held on a foot, and a tired foot wobbles and sags. The spread limit only has to catch
// a boot that never settled, such as one rocking from heel to toe. The central three
// quarters of the samples must sit within the angular spread of their mean.
constexpr unsigned long CALIBRATION_WINDOW_MS      = 2000;  // how long a capture collects the hold
constexpr unsigned long CALIBRATION_NO_SAMPLE_MS   = 500;   // gap in sensor samples that fails a capture
constexpr uint16_t      CALIBRATION_MIN_SAMPLES    = 50;    // half the samples expected at 50 Hz
constexpr float         CALIBRATION_MAX_SPREAD_DEG = 8.0f;  // the middle half of the samples must fit in this
static_assert(CALIBRATION_WINDOW_MS / IMU_SAMPLE_MS <= Firewalker::POSE_CAPTURE_MAX_SAMPLES,
              "A longer capture needs a larger POSE_CAPTURE_MAX_SAMPLES, or it loses its end");

// ── Saved settings ───────────────────────────────────────────────────────
// A burst of slider changes turns into one flash write: it saves after the changes
// pause, or after the longest delay if they never do.
constexpr unsigned long SETTINGS_SAVE_QUIET_MS = 1000;
constexpr unsigned long SETTINGS_SAVE_MAX_MS   = 5000;

// ── Remote control ───────────────────────────────────────────────────────
// Shared by the BLE service and the USB console (docs/remote-protocol.md).
constexpr unsigned long REMOTE_MOTION_REPORT_MS = 200;  // motion lines while debug is on
constexpr unsigned long REMOTE_STATUS_MIN_MS    = 250;  // fastest repeat of change-driven status lines
constexpr uint16_t      REMOTE_ADVERTISE_INTERVAL = 160;   // BLE advertising interval, in 0.625 ms units (100 ms)
constexpr uint8_t       REMOTE_RX_QUEUE_DEPTH     = 8;     // BLE commands waiting for the main loop
constexpr uint8_t       RECIPE_SLOTS              = 16;    // uploaded recipes each boot can keep in flash
constexpr unsigned long RECIPE_UPLOAD_IDLE_MS     = 5000;  // an upload this quiet is abandoned, as after a dropped link
constexpr size_t        REMOTE_TX_BUFFER_BYTES    = 1024;  // reply bytes waiting to go out over BLE
constexpr size_t        REMOTE_ATT_VALUE_MAX      = 244;   // largest notification payload the firmware will send
constexpr uint8_t       REMOTE_NOTIFICATIONS_PER_LOOP = 4; // cap per main-loop pass, so sending can't stall it
constexpr unsigned long IDENTIFY_MS       = 1500;  // how long both strip and onboard LED blink
constexpr unsigned long IDENTIFY_BLINK_MS = 125;   // shared half-period, starting dark
constexpr uint32_t      IDENTIFY_COLOR    = 0xFFFFFF;
constexpr unsigned long APP_FRAME_MS            = 16;   // shortest time between strip frames
constexpr unsigned long APP_OFF_REFRESH_MS      = 1000; // black refresh when off, in case the strip repowers

// ── Idle fill (imu_debug visual) ─────────────────────────────────────────
// imu_debug fills the strip a solid color scaled by motion (the app uses the
// recipe patterns instead).
constexpr uint8_t IDLE_MIN_BRIGHTNESS = 3;   // floor so a still IMU still glows faintly
constexpr uint8_t IDLE_FILL_R = 255;         // warm yellow
constexpr uint8_t IDLE_FILL_G = 200;
constexpr uint8_t IDLE_FILL_B = 0;
