foxyblocks/firewalker/(commit log)

2026-06-01 Firewalker bring-up: PlatformIO Uno firmware + button-triggered color wipe
    PlatformIO + Arduino project for a wearable NeoPixel LED shoe. First test
    board: Arduino Uno R3.
    - platformio.ini: atmelavr/uno, Arduino framework, Adafruit NeoPixel dep
    - src/main.cpp + include/config.h: non-blocking, button-triggered color wipe
    across 39 WS2812B pixels (debounced INPUT_PULLUP button on pin 10)
    - docs/: wiring, power budget, open questions, ADR-0001 (PlatformIO + Arduino)
    - CONTEXT.md domain glossary; CLAUDE.md project notes + agent-skills config
    - docs/agents/: per-repo issue tracker (Linear), triage labels, domain docs
    - .claude/skills + skills-lock.json: Matt Pocock engineering skill suite
    Co-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
    [config.h]
2026-06-01 Fire trails: stacking button-triggered trail animation + doc sync
    Replace the single color-wipe with a multi-trail engine: each press spawns a
    band that travels bottom->top (wipe-in / wipe-out, no hold), and presses stack
    into several concurrent trails (MAX_TRAILS). Each trail is a fire gradient (hot
    head -> red tail) defined by FIRE[] in config.h and cached per TRAIL_LEN.
    - src/main.cpp: Trail[] state, one shared millis() step tick, debounced spawn,
    precomputed fire-gradient render
    - include/config.h: FIRE[] palette + TRAIL_LEN / MAX_TRAILS; dropped HOLD_MS / FILL_*
    - docs: README, CONTEXT glossary, power-budget (recomputed for current
    brightness), CLAUDE phase line — all synced to t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
    [config.h]
2026-06-03 Use Feather RP2040 wiring
2026-06-07 Refactor firmware into per-mode architecture; add FSR stomp sensor
    Split the monolithic main.cpp into a tiny dispatcher plus a shared core
    (src/firewalker_core.cpp: strip, trail engine, sensor reads) and selectable
    runtime modes under src/modes/ (final_app, fsr_debug) chosen at compile time
    via build_flags and include/modes/mode_select.h.
    Replace the D6 button as the primary trigger with a force-sensitive resistor
    voltage divider on A0 (hysteresis: FSR_STOMP_THRESHOLD / FSR_RELEASE_THRESHOLD).
    The D6 button stays as a deterministic bench-test trigger. fsr_debug maps live
    FSR pressure to idle yellow brightness and logs raw readings; final_app runs the
    dark-until-stomp fire trails. Docs, wiri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
    [config.h, final_app.cpp, firewalker_core.cpp, firewalker_core.h]
2026-06-08 Add imu_debug MPU-6050 mode + IMU wiring; onboard NeoPixel in all modes
    New imu_debug mode evaluates a GY-521 / MPU-6050 (6-DOF accel+gyro) over I2C as
    a candidate stomp trigger to replace the FSR. It polls the IMU at ~50 Hz, logs
    accel/gyro over serial, fires a fire trail when total acceleration magnitude
    spikes past a threshold (arm/release hysteresis + refractory gap, mirroring the
    FSR), and maps movement intensity to idle strip brightness when no trail is
    running. The D6 debug button still spawns trails so the animation works even
    without the IMU.
    All MPU-6050 code is confined to the mode; firewalker_core stays sensor-agnostic
    (factored out renderIdleBrightness, shared by the FSR and IM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
    [config.h, firewalker_core.cpp, firewalker_core.h, imu_debug.cpp]
2026-06-08 Design: runtime light patterns + IMU-driven flow
    Capture the design from the flow/pattern grilling session:
    - CONTEXT.md: Mode vs Pattern, Fire-trail, Flow, Orientation, looped Strip.
    - ADR-0002: runtime-switchable patterns; IMU as sole sensor; FSR retired.
    - ADR-0003: orientation from accel + gyro complementary fusion (not gyro alone).
    - open-questions.md: bench-calibration checklist + accepted magenta power risk.
    - power-budget.md: magenta (2-channel) worst-case math.
2026-06-08 Implement flow pattern + Pattern architecture; retire FSR
    Restructure the firmware around runtime-switchable patterns driven by the IMU:
    - Pattern interface (include/patterns/pattern.h); flow (magenta pooling gradient
    from fused fore-aft tilt + a x2 stomp flash that eases back) and fire-trail
    (wraps the trail engine). final_app holds both; D6 cycles; boots into flow.
    - Shared firewalker_imu service: MPU6050 read, complementary-filter fore-aft
    tilt, stomp detect -- used by the app and imu_debug.
    - Retire the FSR: delete fsr_debug, the FSR config + core code; rename the idle
    fill constants; expose strip + add resetTrails in core.
    - imu_debug becomes a calibration tool: logs accel/gyro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
    [config.h, final_app.cpp, firewalker_core.cpp, firewalker_core.h, firewalker_imu.cpp, firewalker_imu.h, imu_debug.cpp]
2026-06-08 Calibrate flow tilt for the ankle mount (fore-aft sign)
    Bench capture with imu_debug (Feather long-axis vertical, USB up, chip side
    out): at rest gravity sits on +Y (~9.84); pitching toe-down swings accel X to
    ~-5.8 (X = heel<->toe) while Z stays ~0 (lateral board normal). Flip
    FLOW_FOREAFT_SIGN to -1 so toe-down -> +tilt -> flow pools toward the toe. The
    Y-vertical and Z-gyro-pitch axes were already correct. Stomp threshold left at
    18 m/s^2 for on-foot tuning.
    [config.h]
2026-06-08 Flow: add tilt deadzone; slow the stomp fade to ~800 ms
    - Deadzone (FLOW_TILT_DEADZONE) ignores tiny near-level tilts so the strip rests
    flat despite the small resting mount offset, then rescales the remaining range
    so a firm tilt still reaches full pooling.
    - Slow the stomp flash falloff: FLOW_STOMP_TAU_MS 120 -> 270 (~800 ms visible
    fade) — the previous ~350 ms read as too quick.
2026-06-09 Flow: darker baseline, full-brightness stomp, more drastic pooling
    Per bench feedback:
    - Baseline 0.5 -> 0.30 (dimmer magenta at level).
    - Stomp is now an absolute flash to full (FLOW_STOMP_LEVEL = 1.0) easing back to
    the pooled value, instead of a x2 multiply -- so every stomp hits 100%.
    - Fade ~1.2 s (FLOW_STOMP_TAU_MS 270 -> 400).
    - FLOW_GAIN 1.0 -> 2.0 so tilt drives the down-end to full and the up-end fully
    off -- much higher on/off contrast.
    Power notes updated: every stomp now flashes the whole strip to full magenta
    (~612 mA), not just near-level ones.
2026-06-09 Flow: spectrum-cycling hue + stomp-launched divergent trails
    Combine the trail concept into flow:
    - The strip now shares one hue that slowly rotates through the spectrum
    (FLOW_HUE_CYCLE_MS); tilt still pools brightness toward the down-end.
    - A stomp launches up to 4 trail fronts from the tilt-derived fore-aft "down"
    point: toe-down -> from the toe, heel-down -> from the heels, flat -> from
    mid-foot (~25%/75%). Each side gets two diverging fronts heading to its heel
    and toe ends; fronts with no room are skipped. Bands are clamped to their side.
    - Trail band gradient: white head -> current hue (full) -> the previous hue in
    the rotation (FLOW_TRAIL_PREV_HUE); it tracks the live hue.
    -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
    [config.h]
2026-06-11 IMU bring-up: left-boot calibration, flow fill-gauge, force trails
    Calibration (bench-confirmed on both boots via imu_debug):
    - Per-foot IMU mount signs. The two GY-521s are mounted inverted about the
    heel-toe axis (right VCC-down, left VCC-up), so the vertical and pitch-gyro
    signs flip per foot while fore-aft stays the same. Replaces the earlier
    sagittal-mirror assumption (which was wrong for the left boot); the right
    boot's confirmed signs are unchanged.
    - Trim each boot's sole-flat fore-aft cant (IMU_MOUNT_FOREAFT_REST_DEG) so a
    flat foot reads level instead of pooling to the heel.
    Flow reworked into a tilt "fill gauge":
    - At level every pixel is lit at baseline; tilt extinguis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
    [config.h, final_app.cpp, firewalker_core.cpp, firewalker_core.h, firewalker_fusion.h, firewalker_imu.cpp, firewalker_imu.h, firewalker_strip_map.h]
2026-06-11 Add tools/flash-all.py: flash each connected boot by serial
    Identifies each boot by its USB serial number (stable per board, unlike the
    floating /dev/cu.usbmodem* port) and flashes the matching foot env to its
    current port, one at a time so picotool can't grab the wrong board. `--list`
    prints the serial->foot mapping without flashing; unknown boots are listed so
    their serial can be added to the BOOTS map. Documented in CLAUDE.md.
2026-11-03 Add MG24 bench CLI, strip diagnostics, and motion fixes
    Add D10 strip tests and a Go CLI for color, off, flow, fire-trail, and motion runs. Preserve LED pulse timing across compiler optimizations and correct the MG24 pitch direction with regression coverage.
    Document the confirmed BTF strip, hardware validation, and migration scope for shared firmware and BlePad controls.
    [config.h, firewalker_fusion.h, firewalker_imu.h]
2026-11-03 Spec: support the mg24 CLI and defer the remote app choice
    Name the mg24 Cobra CLI as a supported control and debug interface
    alongside the iPhone remote, and move it to the pinned toolchain before
    the Arduino CLI workflow is removed. Leave the BLE remote app choice open
    between an existing app such as BlePad and a custom Capacitor app.
2026-11-03 Build the MG24 app and diagnostics from root PlatformIO
    Make the XIAO MG24 Sense the default target of the root project: the shoe app,
    motion calibration, color, off, and a flag-configured bench build. The Feather
    environments and the prototype sketch keep building until the MG24 passes its
    hardware checks.
    Add per-controller saved settings, neutral calibration, and a remote control
    channel over USB and BLE that share one text protocol. Move the mg24 CLI to the
    pinned PlatformIO toolchain and drop its probe command.
    Seeed's platform always builds the Matter variant and its compiler can't link
    Silicon Labs' Bluetooth libraries, so a build step selects the stack and pins Arm
    GNU 12.2.rel1. U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
2026-11-03 Document the MG24 setup, remote protocol, and decisions
    Rewrite the README, wiring guide, power budget, open questions, glossary, and agent
    orientation for the MG24 and FCOB strip. Add the remote protocol reference and an ADR
    that brings BLE into scope. Update the spec for the Capacitor decision and the working
    USB serial port, and refresh stale comments about the old mount.
2026-11-03 Restore the strip's tested pulse timing
    Moving the driver out of the prototype passed the pulse widths in as arguments, which
    moved their memory loads outside each bit's timed interval. That stretched high pulses
    by a few cycles and brought back the stray pixels the prototype had already fixed. Load
    the widths inside the interval again, so the send loop compiles to the same instructions
    as the prototype's confirmed one.
    [firewalker_strip.h]
2026-11-03 Fix flash-write coalescing and the BLE name's id
    The main loop read the clock before handling commands, so a change stamped during that
    pass looked like it came from the future and its elapsed time wrapped around. That
    saved settings on nearly every slider update, skipped the status rate limit, and could
    hand patterns a huge frame time after switching. Read the clock after commands, and make
    the save scheduler's elapsed times signed so a stale reading can't wrap.
    The Bluetooth stack can boot before setup() runs, which left every controller advertising
    as Firewalker-0000. Load the id on first use, whichever side gets there first.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
    [final_app.cpp, firewalker_remote.cpp, firewalker_settings.h]
2026-11-03 Rename the bench tool to cli
    Run it as ./cli from the repo root, with sources in tools/cli. The name mg24 stays on the
    board-specific build step and environments, which are about the hardware.
2026-11-03 Generate the strip signal with SPI and DMA
    With the Bluetooth stack in the build, CPU-timed pulses stretched about one zero in 3000,
    some as long as a one, even with interrupts off, and that lit stray pixels. The same code
    was clean with no radio. Send each frame through SPI hardware at 3.25 MHz instead, with
    four SPI bits per LED bit, so the hardware sets every edge and interrupts stay on. This
    also claims D8 and D9, which have to stay unconnected.
2026-11-03 Fix the strip's first pixel sticking on green
    The SPI hardware raises D10 for its first bit before its clock starts, which stretches
    that first high pulse. Every encoded LED bit starts high, so the first pixel's top green
    bit always read as a one. Start each frame with a zero byte, so the stretch never reaches
    a real pulse. Captured on the pin, the frame's first zero now matches the others.
2026-11-03 Document the boot's 69 cm strip and its power draw
    A boot needs about 69 cm of strip, or about 110 pixels, which by the manufacturer's rating
    draws about 5.5 W, or 1.1 A at full white. The firmware keeps assuming the uncut 160 pixels
    until the cut point is settled. Have the cli tool read the strip length and ring positions
    from config.h, so changing them there is enough.
2026-11-04 Report repeat calibration failures
    A capture that failed the same way as the previous one sent no calibrate line, because the
    app only reported changes in the capture's state. A repeat sensor-unavailable, or a capture
    that failed before its first report, was left with just the ack. Clear the reported state
    when a capture starts, so every capture gets its own result line.
    [final_app.cpp]
2026-11-04 Add heel and toe calibration and the app's protocol additions
    Each boot can now capture neutral, heel, and toe poses while worn, and maps them to tilt 0,
    -1, and +1, with each side scaling on its own range. A skipped side keeps the 30 degree
    default, and direction comes from the poses, so a backward-mounted controller corrects
    itself. The dead zone moves from a fraction of tilt to 3 degrees, so a short side can't
    shrink it below what a capture can be off by. Saved settings change shape, so test boards
    reset to defaults once.
    Add what the iPhone app needs: a patterns command, an identify blink that changes no
    settings, proto and lit in status, and accelPeak in motion lines. Raise the line li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
    [config.h, final_app.cpp, firewalker_calibration.h, firewalker_core.h, firewalker_imu.cpp, firewalker_imu.h, firewalker_remote_protocol.h, firewalker_settings.h]
2026-11-04 Remove the Feather and prototype paths
    The MG24 passed its bench checks through the root PlatformIO project: colors, off, flow,
    fire-trail, and motion, all on the actual strip. Remove the Feather environments, the
    MPU-6050 and button code, left/right builds, tools/flash-all.py, the prototype sketches and
    its Arduino CLI workflow, and the guides for that hardware. Drop the helpers and settings
    only that code used. The decision records keep the history.
2026-11-04 Add the Capacitor iPhone app shell and boot protocol
    Start the remote app in app/: Capacitor 8 with React, Vite, and TypeScript, packaged
    with Bun. The UI ships inside the app bundle, so it runs with no network. The iOS
    project uses Swift Package Manager and already compiles for the Simulator.
    protocol.ts holds the command spellings and reply parsing, with tests checked against
    the lines in the firmware's protocol doc. It tolerates fields it doesn't know, so the
    firmware can add to the protocol without breaking installed apps.
2026-11-04 Add the boot client, boots store, and fake boot
    BootClient is the connection to one boot: it reconnects on its own, sends one command
    at a time, keeps only the newest slider value, and reads a capture's result however it
    arrives. A tap stays pending until a status line settles it, so a control never claims
    something the boot didn't do.
    BootsStore owns the pair: Left and Right labels saved on the phone, the Both tab's
    fan-out, and the pattern tiles built from what each boot reports.
    FakeBoot speaks the real text protocol, modeling both today's firmware and the
    additions on the migration branch, so the tests run all of the real client code.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
2026-11-04 Add the remote's screens and real Bluetooth
    Remote, Status, Find boots, and a guided three-pose Calibrate flow. Patterns scroll in
    the middle of Remote while brightness, power, and Calibrate stay pinned at the bottom,
    so more patterns never push them out of reach. The tile list comes from what each boot
    reports, so a pattern added in firmware shows up with no app update.
    ble.ts is the real radio for both iOS and Chrome, and setup.ts falls back to pretend
    boots only in the Simulator or with ?boot=fake, labeled on screen. Every newer firmware
    feature has a fallback, so the app also works on older builds.
    Fonts are bundled, so nothing needs a network. Run and install steps are in
    app/README.m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
2026-11-04 Find the pose in a wobbly hold instead of failing on a wobble
    Heel and toe captures were nearly impossible while wearing a boot. The firmware already
    averaged the hold, but any one sample past its rotation, acceleration, or spread limits
    ended the capture on the spot, and a foot held up by muscle trembles past those limits.
    Collect the whole window, now two seconds, and judge it at the end using only the middle
    half of the samples. Tremor, a slow sag, a brief stumble, and settling in late all still
    capture, because the outliers sort to the ends and get left out. A capture only fails if
    that middle half is spread over more than 8 degrees, which means there was no one pose to
    find, such as a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
    [config.h, final_app.cpp, firewalker_calibration.h]
2026-11-04 Stop losing the iPhone's scan to repeated Bluetooth checks
    The iPhone never listed any boots. On iOS, each BleClient.initialize builds a new
    Bluetooth manager and discards the old one, along with any scan or connection it was
    running. The app called it at startup, on mount, and on every return to the foreground, so
    the mount check killed the scan Find boots had just started. A return to the foreground
    would have done the same to live connections. Chrome doesn't work that way, so this only
    showed up on a phone.
    Start Bluetooth once, and retry only after a failed start.
    Also keep a scan result that has no name yet. The firmware's name is in its scan response,
    which can arrive after the adver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
2026-11-04 Fix the bugs a review found in captures and connections
    The worst one: the firmware sends a status in the same loop pass as a capture's ack, before
    it records that the capture started, so that status still holds the previous result. About
    half the time, the app took that as this capture's result, showing Done or a repeat failure
    while the boot was still collecting. Set the state when the capture starts, and have the app
    only read a result from status after its wait for the calibrate line runs out.
    Connections:
    - One boot being off no longer stalls the other. The plugin's queue ran one call at a time
    across all devices, so a connect attempt held up commands to the boot that was on.
    - Retur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
    [config.h, final_app.cpp, firewalker_core.h]
2026-11-04 Drop support for older firmware
    Both boots run firmware with the current protocol, so the fallbacks written for older builds
    are dead code: the lights-off-and-on blink, the built-in pattern list, hiding heel and toe,
    guessing the pattern power on restores, and the fake boot's second firmware generation.
    Keep one check in their place. A boot reporting a protocol older than the app needs gets a
    banner asking you to update its firmware, rather than a half-working experience.
    A pattern list request that goes unanswered now retries on the next status line, since there's
    no longer a built-in list to fall back on.
2026-11-04 Give capture reporting its own tested module
    A capture's state lived in three places in final_app.cpp, kept in step a loop pass apart, in
    a file the native tests can't reach. That's how a status line came to report the previous
    capture's result as this one's.
    PoseCalibrator now owns a capture from command to reported result: the ack's answer, the
    status text, and each report, once. Its status text is correct from the moment a capture
    starts, so that bug can't come back, and the ordering rules are covered by native tests.
    final_app.cpp only drives it and sends the lines. The protocol on the wire doesn't change.
    [final_app.cpp, firewalker_calibration.h, firewalker_remote_protocol.h]
2026-11-04 Make the strip's LED count, toe, and heel saved settings
    Each boot now saves its own pixel count and toe and heel pixels, set over
    the remote with new `strip` commands. A `strip preview` command shows what
    is being set: a blue fill for the count, one yellow pixel for the toe, and
    one purple pixel for the heel. It ends a minute after the last strip
    command, so a phone going away can't leave a boot stuck on it.
    Toe and heel can now fall in either order, since a mirrored boot can run
    the strip the other way around. Settings saved by earlier firmware still
    load, so updating doesn't lose a boot's calibrated poses.
    [bench.cpp, config.h, final_app.cpp, firewalker_core.cpp, firewalker_core.h, firewalker_remote_protocol.h, firewalker_settings.h, firewalker_settings_store.cpp]
2026-11-04 Add LED count, toe, and heel sliders to the Calibrate sheet
    A new Strip tab sets each boot's layout while the strip previews it. The
    sliders follow a finger, and minus and plus buttons land on the exact pixel.
2026-11-04 Reconnect to boots after a browser page reload
    A reload left boots on Reconnecting forever, because the app never asked the
    browser for the boots it remembers, and the plugin only knows about ones picked
    since the page loaded. The only way back was to forget and re-add each boot.
    In a browser with the persistent permissions flag, boots now reconnect by
    themselves. That browser reports a remembered boot as out of range until it has
    heard it advertise, so the app waits for that first. In a browser without the
    flag, nothing can reconnect without a tap, so the app stops retrying and shows a
    Reconnect button. Picking a boot there keeps its side and name, matching it by its
    advertised name becaus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
2026-11-04 Start fire trails from the part of the boot that's down
    Fire trail ignored tilt and ran one band from pixel 0 to the end of the strip,
    which on a ring around the foot doesn't follow the boot at all. A stomp now
    starts from the toe, the heel, or both mid-foot points, depending on the tilt at
    that moment, and runs along both sides of the foot to the opposite part. A flat
    stomp runs outward to both ends.
    The routes are pure math in firewalker_trail_path.h, using each boot's saved toe
    and heel, so a mirrored ring or a cut strip works the same way. Flat gets a wider
    band than the motion service's dead zone, because a foot rarely lands level.
    Each stomp logs its tilt and origin over USB, for tun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
    [config.h]
2026-11-04 Give fire trail knobs for its flat range and speed
    Flat was a fraction of the way to each captured pose, so its size in degrees
    varied by boot and side, and on the left boot a stomp 6 degrees off level
    started from the heel. It's now FIRE_TRAIL_FLAT_DEG, a plus or minus tolerance
    around the neutral pose. The default of 8 sits between the angles logged for
    flat stomps and heel strikes on that boot.
    Speed is now FIRE_TRAIL_SPEED_PXPS in pixels per second, like flow's trails,
    in place of milliseconds per pixel. It doubles to 200, because trails looked too
    slow.
    Patterns get the angle through a new tiltDeg input, which has no dead zone and
    doesn't stop at the poses, unlike tilt.
    Co-Authored-B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
    [bench.cpp, config.h, final_app.cpp, firewalker_calibration.h, firewalker_imu.cpp, firewalker_imu.h]
2026-11-04 Split the bench CLI into packages
    Moves the bench test description to internal/bench and board discovery to
    internal/boards, with no change in behavior. Cobra stays in main. The TUI and the
    subcommands will share these.
    Adds internal/protocol, which sorts a boot's USB lines into replies (ack, status,
    motion, calibrate, patterns) or plain logs, and tolerates proto 1 status lines
    that have no strip layout.
2026-11-04 Teach the bench CLI about each boot's saved strip layout
    Pattern tests now light the strip a boot actually has. Without --pixels, the CLI
    asks the boot for status, remembers its LED count, toe, and heel by USB serial,
    and falls back to that memory and then config.h when a bench build can't answer.
    It prints which source it used.
    - Toe and heel work in either order, matching stripLayoutValid in the firmware.
    - `./cli app` flashes final_app onto one named board.
    - `--debug` stays attached after an upload and streams the board's output, in
    place of handing off to `pio device monitor`. Ctrl-C leaves the board running,
    and piped output gets raw lines with no color.
    - Board discovery asks the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
2026-11-04 Add the bench CLI's TUI
    Bare `./cli` in a terminal now opens a full-screen app for flashing and debugging
    a boot. Piped, it still prints help, and the subcommands work as before.
    - The board bar lists every boot on USB and each one seen before, with a tag for
    what's running. A lone boot is picked for you. With two, nothing flashes or
    sends until `tab` picks one.
    - Bench test is the subcommands as a form, on the boot's real strip layout, with
    a live preview of the matching `./cli` command. It goes through the same
    validation as the flags, and a test checks the preview parses back to the same
    test. Its layout fields only build that one test; they never touch what the
    boot has save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
2026-11-04 Add ./cli web to build and open the phone remote in a browser
    Runs bun install and bun run build in app/, serves the result at
    http://localhost:5173 with vite preview, and opens the browser once it answers.
    Ctrl-C stops the server. --dev uses the hot-reload server instead, --fake opens
    with pretend boots, and --no-open only prints the address.
    It always stays on port 5173, because a browser keeps boot labels and Bluetooth
    permissions per origin, and that includes the port. A taken port is an error
    rather than a reason to pick another one.
    Moves the process-group helper into internal/proc, so flashing and the web server
    stop their child processes the same way.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
2026-11-05 Space out the Add buttons on Find boots
2026-11-05 Make tab switch screens and give boots their own picker
    Tab and shift+tab now move between screens, which is what they look like they
    should do. Boots move to `p`, which opens a list of each boot's id, USB serial, and
    tag, and nothing changes until Enter, so picking is still never a guess. The tabs
    all read as a number and a plain name, without the FLASH and DEBUG group labels
    that made the row hard to read.
    ctrl+j and ctrl+k scroll the log, for keyboards with no page keys. A test runs them
    through Bubble Tea's real input parser, because Enter on the bench form leads to a
    flash and a scroll key must never look like Enter.
2026-11-05 Animate stomps in the side view, and add beat stomps
    A stomp now lifts the boot and drops it, and the pattern gets the stomp
    on the frame it lands, with dust, a squash, and a shadow that shows the
    height. Walking lifts the foot through the swing too.
    Beat stomps on every beat at a BPM you set (30 to 240), landing on the
    beat at the strength slider's value. Beat and Walk turn each other off.
    The stomp button now lights when a stomp lands, whatever started it.
    Claude-Session: https://claude.ai/code/session_01MCPFYSe1Q28n7f6taVuVzX
2026-11-05 Add the spec for the recipe engine, built-ins, and upload
    Covers the phase that gets recipes running on boots: the designer's
    JSON-to-binary compiler, the binary layout and its 254-byte limit, the C++
    engine and the reference frames that check it, a dynamic pattern list with a
    settings migration, upload commands, recipe version reporting, reserved names,
    and the flash, RAM, and frame-time checks on a board. No firmware code yet.
    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
2026-11-05 Reserve flow and fire-trail as pattern names
    A boot lists recipes by name beside its own patterns, so a recipe named flow
    would clash with the built-in one.
    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
2026-11-05 Show what a boot's brightness does to a pattern in the simulator
    Boots default to brightness 16, which leaves 17 steps per color channel, so
    fades jump and very dim colors shift or go black. The simulator hid all of that.
    A new Boot brightness setting runs each frame through the firmware's own math.
    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
2026-11-05 Add reference frames for the firmware's recipe engine
    Saves what the TypeScript engine draws for a fixed script of motion, for the
    kept recipes and for small recipes that cover every layer type, blend, choice,
    and knob source. A native test can check the C++ engine against these files
    with no boot. A test fails if they go out of date, and if a new layer type,
    blend, choice, or source has no case.
    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
2026-11-05 Update the recipe engine spec for the finished fixes
    Reference frames, the reserved names, and the simulator's brightness setting
    now exist, so the spec describes them that way.
    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
2026-11-05 Stop tying the reference frames to patterns/
    Every recipe saved in patterns/ made the frames stale, so tuning a pattern broke
    the tests until someone regenerated them. The frames now use only the small test
    recipes that live beside them, which still cover every layer type, blend, choice,
    and knob source. Those recipes are now edited by hand, not generated, and each
    runs on both strip layouts so toe-first and heel-first rings are still covered.
    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
2026-11-05 Make reference frames from compiled recipes
    The frames now come from a recipe that's been compiled and decoded, which is
    what a boot would really be given, so rounding in the binary format can't cause
    a false failure in the C++ test. The compiled bytes are saved beside them, which
    also pins the binary layout.
    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
2026-11-05 Run the designer and firmware tests on every pull request
    The repo has no commit hooks, so generated files and reference frames only stay
    honest if something runs these checks.
    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
2026-11-05 Port the recipe engine and decoder to C++
    Both are pure headers, so they run off-hardware. The engine matches every frame
    saved from the TypeScript engine within 1 per channel. The decoder refuses or
    limits anything malformed, and a sweep that changes every byte of every test
    recipe, then runs the engine on whatever's accepted, passes with memory checks
    on. The motion script gained a stall past the 250 ms limit, so both engines'
    limits are checked against each other.
    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
    [firewalker_recipe.h, firewalker_recipe_engine.h]
2026-11-05 Add a bench build that measures recipes on a real board
    The recipe format's limits have to be checked at the chip's 39 MHz before
    version 1 freezes. This runs the kept recipes and the heaviest legal ones on the
    real strip with the Bluetooth stack running, and logs engine time, frame rate,
    and memory over USB.
    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
2026-11-05 Know patterns by name, and build in a chosen set of recipes
    A fixed enum can't hold uploads, so a pattern is now a name everywhere, including
    in flash. Settings become version 4, and a version 3 or 2 record upgrades on load
    with its poses and strip layout intact. A saved name that no longer exists falls
    back to flow and keeps the rest.
    patterns/built-ins.txt picks the recipes compiled into the firmware: comet,
    fire-stomp, and rainbow-pool. A firmware build fails if the generated header is
    out of date. final_app can now show any of them, and the remote protocol moves to
    version 3.
    Claude-Session: https://claude.ai/code/session_01MCPFYS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
    [config.h, final_app.cpp, firewalker_pattern_list.h, firewalker_recipe.h, firewalker_remote_protocol.h, firewalker_settings.h, firewalker_settings_store.cpp]
2026-11-05 Upload, list, and delete recipes over BLE and USB
    A recipe is too big for one command, so a client sends 15 bytes a line, waiting
    for each reply. Nothing touches flash until the whole recipe passes its checksum
    and the decoder, and saving is one NVM3 write, so a dropped link or a power cut
    can't damage a recipe that's already saved. Uploads live in 16 slots, survive a
    firmware update, and can hide a built-in of the same name until deleted.
    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
    [config.h, final_app.cpp, firewalker_pattern_list.h, firewalker_recipe_store.cpp, firewalker_recipe_store.h, firewalker_recipe_upload.h, firewalker_remote_protocol.h]
2026-11-05 Raise the brightness cap to 96 for 107-pixel boot strips
    Every boot strip is now cut to 107 pixels or fewer, so a cap of 96 keeps a full-white frame near 400 mA by the strip's rating, inside a USB 2.0 port's 500 mA. The default moves to 67 to stay at 70% in the app, and the simulator follows. The power docs replace an unsourced 500 mA limit with what Seeed's schematic shows, including a 1 A diode that its wiring sheet and block diagram disagree on.
    Claude-Session: https://claude.ai/code/session_01MCPFYVCbWzgUBBJQPi3sLH
    [config.h]
2026-11-05 Say only what was checked about the 5V pad's rating
    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
2026-11-05 Speed up the recipe engine on the board
    The first measurements at 39 MHz had every heavy recipe over its 9 ms target,
    and the worst at 168 ms a frame. The chip has no hardware for doubles, so
    per-pixel loops no longer use them or library calls, a trail's or comet's colors
    are worked out once, each blend gets its own loop, and the engine builds with
    -O2. The worst is now about 12 ms, and the output still matches the reference
    frames. The speed test now also measures at 107 pixels, what the boots really are.
    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
    [firewalker_recipe_engine.h, recipe_budget.cpp]
2026-11-05 Keep uploads reliable over USB
    On a real boot, 2 to 7% of 46-character lines lost characters, because the board
    buffers only 32 received bytes until the main loop reads them. A line over USB now
    carries 7 bytes, which keeps it to 31 characters. About 0.3% of short lines are
    still damaged, so every command in the upload path now retries. A damaged recipe
    was never saved either way, because of its checksum.
    The designer's upload code then got 65 of 65 uploads through on a real boot.
    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
    [firewalker_remote.cpp]
2026-11-05 Match the simulator's 3EB5 preset to the boot
    The boot's heel is now pixel 18. The reference frames and the engine's tests used
    that preset, so a re-cut boot would have made them stale. They now have their own
    fixed heel-first layout, with the same frames under new file names.
    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
2026-11-05 Say what's holding a boot when Send to boot can't connect
    Only one program can have a USB port open, and the browser's error doesn't say
    which, so it was hard to tell what "something" was. The dev server now asks the
    system, and the panel names it. For our own bench tools there's a Free it button
    that sends SIGTERM and connects again. The server checks an allow-list of what's
    running at that moment, and browsers and anything else are never closed. A failed
    Bluetooth connection now says it's usually the phone app.
    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
2026-11-05 Freeze recipe format version 1 at the current limits
    foxy kept the limits after the measurements on boot 3EB5, so version 1 is
    now fixed. Any change to a field, its order, an option, or a limit is
    version 2.
    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
2026-11-05 Replace the hard brightness cap with a soft cap the remote can turn off
    Each boot now holds brightness at a soft cap of 96 unless someone turns it off with `cap off`, and saves whether it's on. With it off, brightness goes to 255, for a boot on a dedicated 5 V supply. A new boot starts at the cap, with the cap on. Records saved before the cap load capped and keep their poses and strip layout, because the flag uses a byte those records left as zero.
    Status gains `capped` and `capBrightness`. `maxBrightness` still means what `brightness` accepts right now, so older apps stay inside the cap, and no protocol version change is needed. The phone remote gets a Cap toggle beside the brightness perc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
    [config.h, final_app.cpp, firewalker_remote_protocol.h, firewalker_settings.h]
2026-11-05 Let bench builds set any brightness again
    Every mode file compiles into every build, so the check that a new boot's default brightness fits under the soft cap also ran in bench builds, where ./cli passes its own brightness up to 255. `./cli flow --brightness 200` failed to compile. The check now applies only to the app build, which still refuses a default over the cap.
    [final_app.cpp]
2026-11-05 Mark the brightness levels above the soft cap
    While a boot's soft cap is off, the brightness slider marks where the cap sits: a yellow line in the gap before the first segment over it, with a warning sign above, and a fine yellow cross-hatch on every segment past the line, lit or not. firstPixelOver works out where that is, so the line lands between segments.
    The warning text under the slider moves into a tip on the warning sign. The sign is a 44-pixel button outside the slider, so a tap on it doesn't set the brightness, and a second tap, a tap elsewhere, or Escape closes the tip. The slider still carries the warning as its aria-description.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
2026-11-05 Drop the 5 V supply advice from the cap tip
    The cap tip, which is also the brightness slider's description, now only says what the levels past the line can draw. The app's README describes the cap the same way.
2026-11-05 Move microphone tuning into boot remote calibration
2026-11-05 Release audio calibration navigation after lost replies
2026-11-09 Support 3D boot calibration and per-boot controls
2026-11-13 Remove the idle auto-disconnect from the remote, designer, and CLI
    Connections no longer drop after two minutes without input, or when a web
    tab is hidden. The shared timeout setting (config/control-surfaces.json)
    and its readers in TypeScript and Go are gone.
    The deliberate ways to release a boot stay: the desktop designer's
    Disconnect/Reconnect buttons and the debug dashboard's Space pause.
2026-11-13 Move BootSession and recipe checks into shared/, add the catalog builder
    The iPhone app needs to upload compiled recipes without the designer's
    compiler. BootSession, the CRC, the size limit, the name rule, and the
    pretend boot's recipe slots now live in shared/, and the designer
    re-exports what it used before. BootSession gains uploadRecipe and
    recipeInfo, so a caller can put a recipe on a boot without selecting it.
    designer/server/catalog.ts compiles every recipe in patterns/ into one
    deterministic JSON file, and bun run build-catalog writes it.
2026-11-13 Sync main's patterns to boots from the phone
    syncPlan.ts decides, per boot, what to delete, upload, and skip: upload
    what's new or changed, hold back what the firmware can't read, delete
    only uploads this phone put there that main dropped, and leave designer
    experiments alone. patternSync.ts runs that plan when a boot comes
    online or a newer catalog arrives, one queue turn per recipe, never
    selecting a pattern, with a per-boot pause for future live editing.
    Fake boots now attach recipe slots through one helper, so tests, the
    phone's fake mode, and desktop demos share it.
2026-11-13 Turn on pattern sync in the iPhone build, with a quiet status line
    native.tsx downloads the catalog at launch and on returning to the
    foreground, through CapacitorHttp because the CDN sends no CORS
    headers, and starts PatternSync. The Remote screen shows "Syncing
    patterns 3 of 7" while it runs, nothing when up to date, and a notice
    when a boot needs a firmware update or runs out of slots. Tiles for
    patterns this app doesn't know take main's description, clamped to
    two lines.
    In Chrome, bun run dev:native serves a live catalog from patterns/, and
    the pretend boots take recipes, with &slots= and &versions= to try the
    problem notices.
2026-11-13 Publish the pattern catalog to the CDN on every push to main
    A separate workflow runs the recipe tests, builds the catalog, and
    uploads it to the CDN's R2 bucket with a one-minute cache. It needs
    three repository secrets (R2_ACCOUNT_ID, R2_ACCESS_KEY_ID,
    R2_SECRET_ACCESS_KEY) and fails with a clear message until they exist.
